spasutto/SimpleBTVario/(commit log)

2018-09-06 Add schematic
2018-09-06 Add schematic to readme
2018-09-06 Added battery charger
2018-09-07 Melody at awakening + adjusted VBat reading
    3.6V => 0%
    4.2V => 100%
2018-09-13 Pressure compensation + NMEA commands
2018-09-20 Correction readVcc/schema + readme
    [SimpleBTVario.ino]
